siddheshmm/photoresistor-reservoir/echo_state_check.png

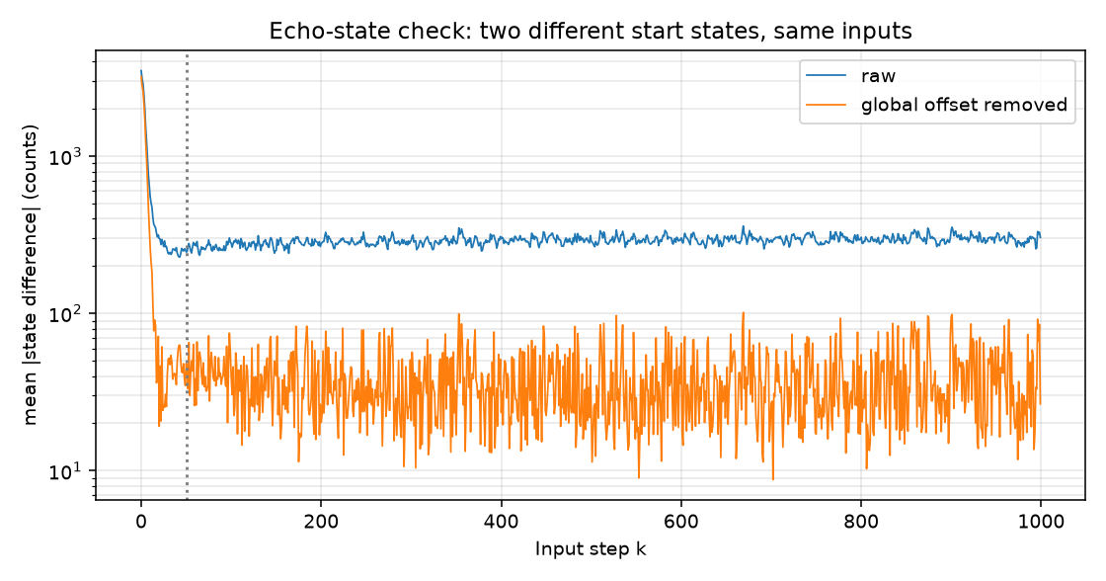
echo_state_check.png
