siddheshmm/photoresistor-reservoir/outputs/phase0/A_dark_noise_floor.png

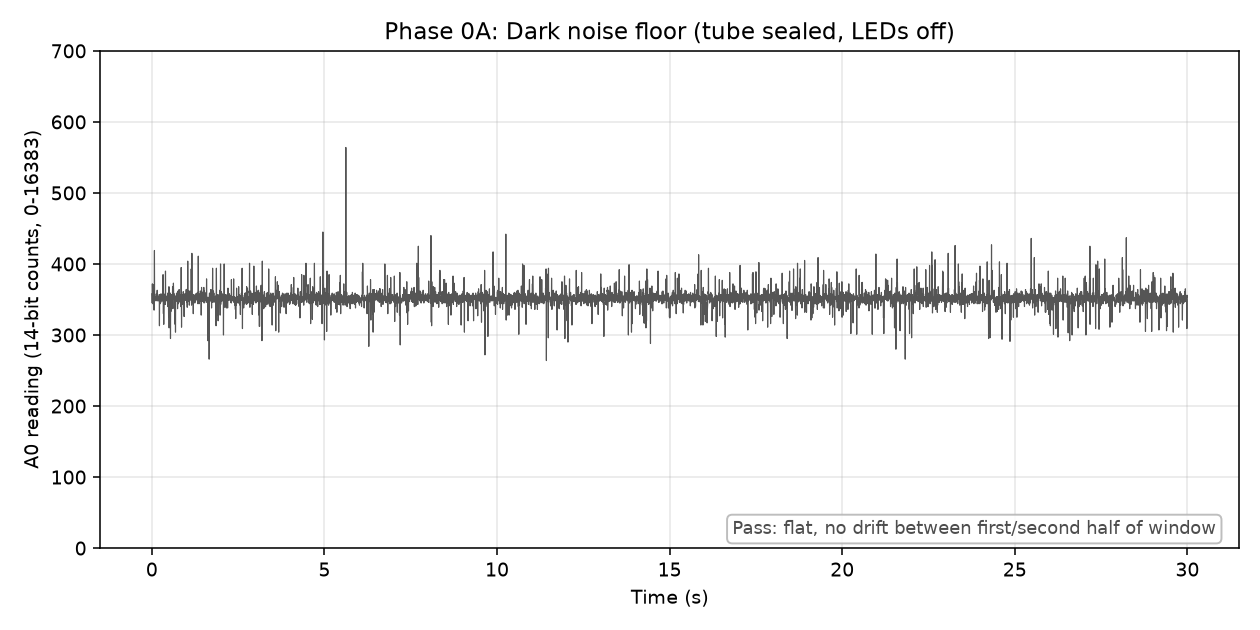
outputs/phase0/A_dark_noise_floor.png
