siddheshmm/photoresistor-reservoir/outputs/phase0/B_ambient_light_leakage.png

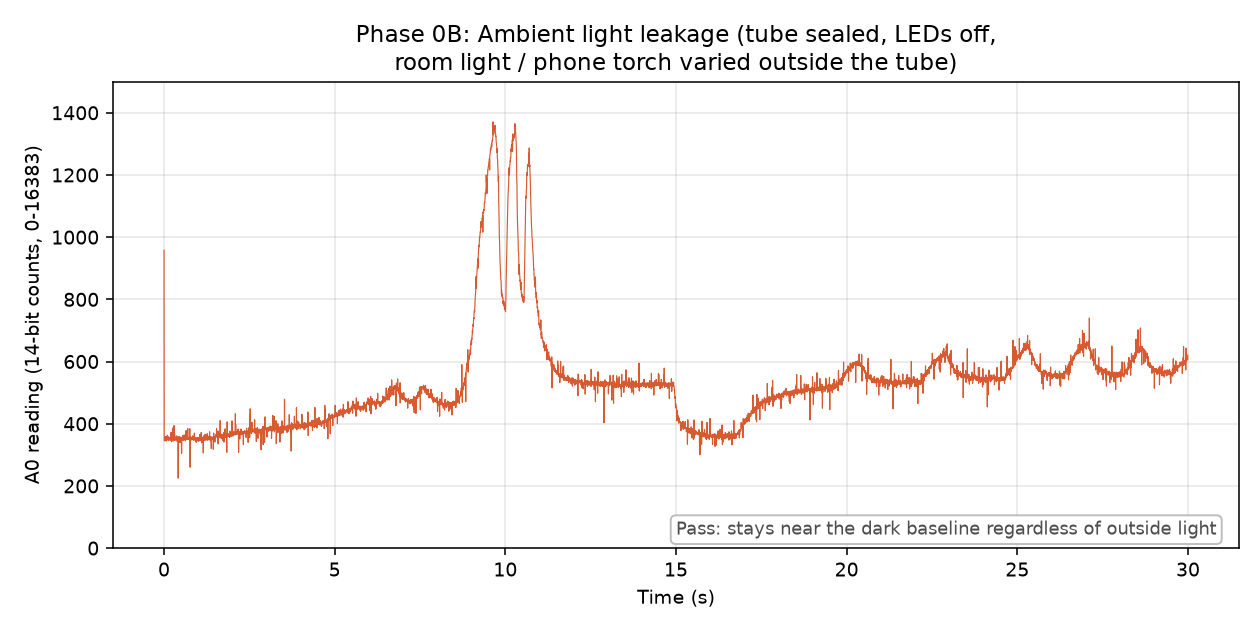
outputs/phase0/B_ambient_light_leakage.png
