siddheshmm/photoresistor-reservoir/outputs/phase0/C1_short_to_GND.png

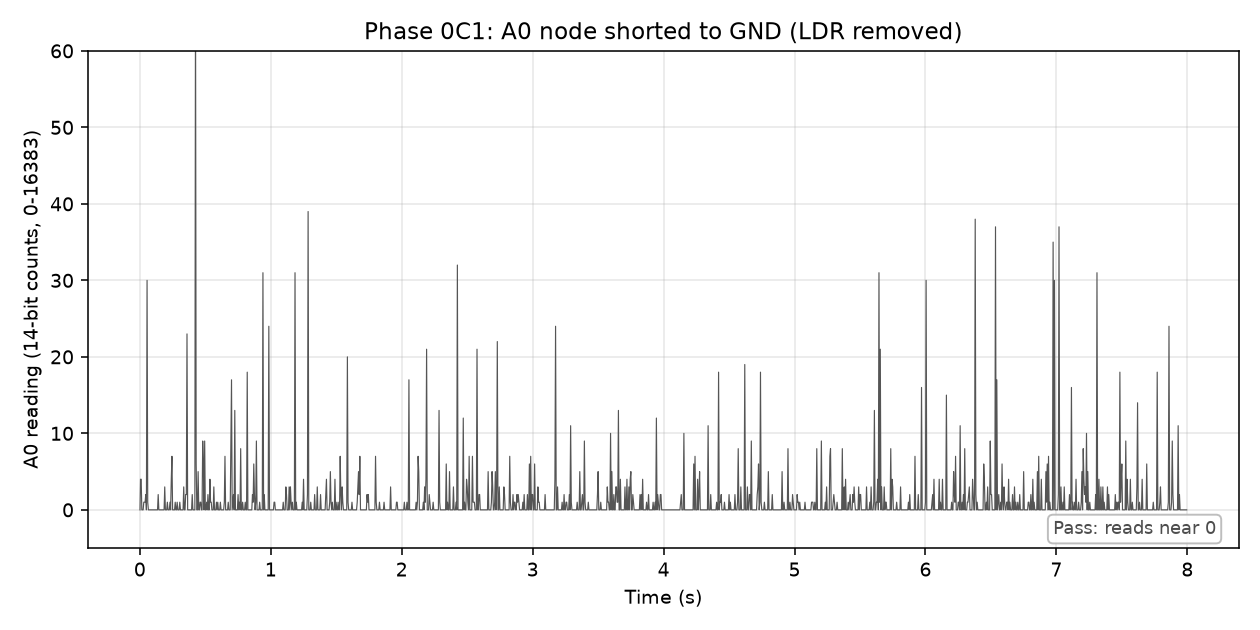
outputs/phase0/C1_short_to_GND.png
