siddheshmm/photoresistor-reservoir/outputs/phase0/C2_short_to_5V.png

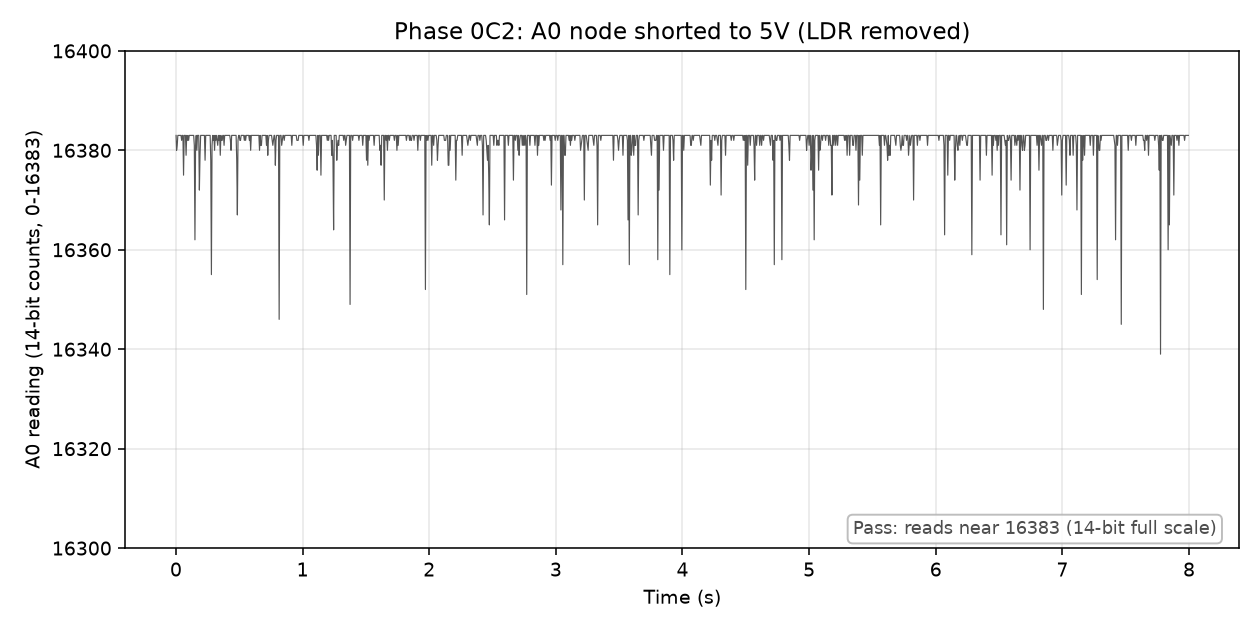
outputs/phase0/C2_short_to_5V.png
