siddheshmm/photoresistor-reservoir/outputs/phase0/phase0_overview_all_stages.png

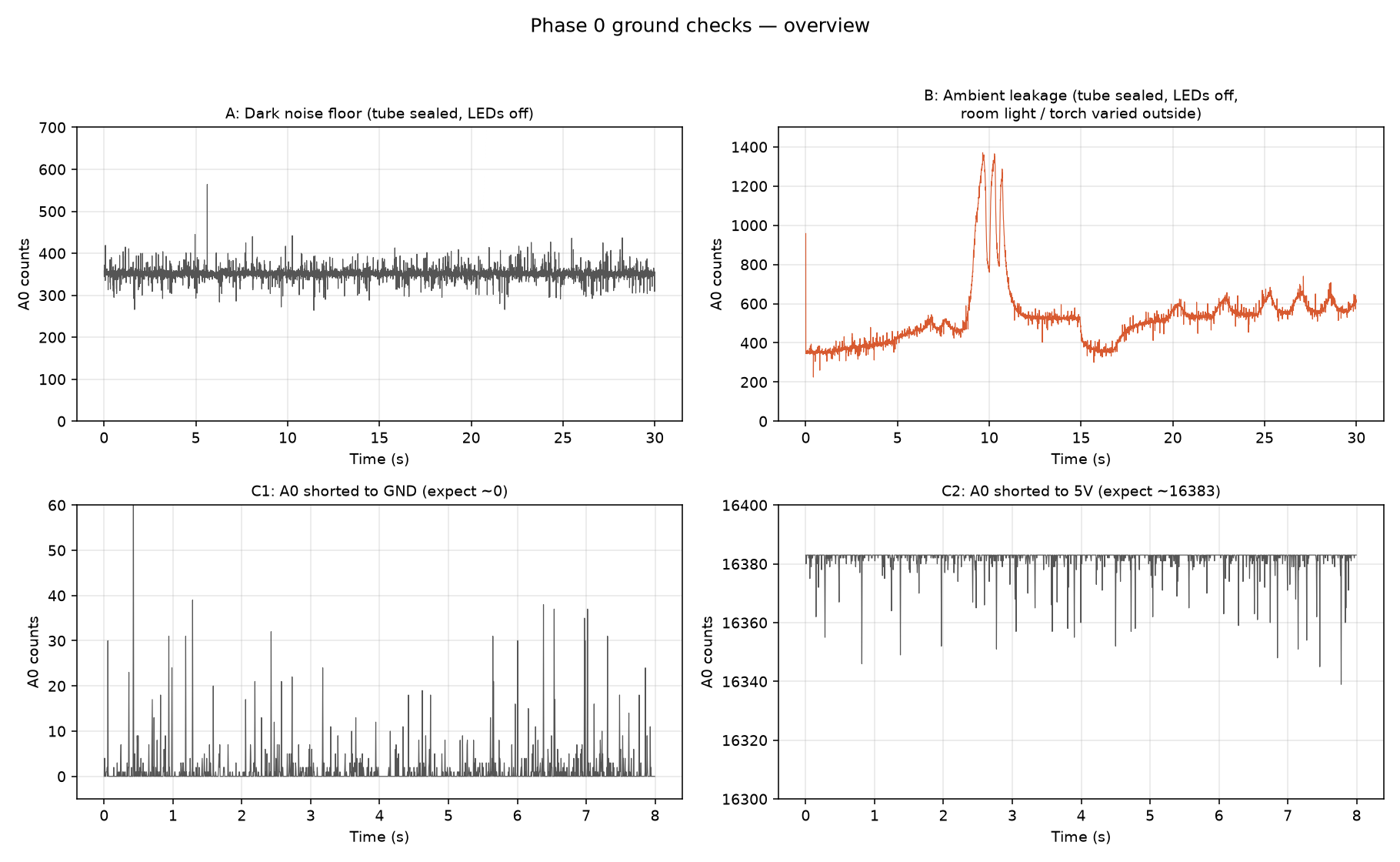
outputs/phase0/phase0_overview_all_stages.png
