siddheshmm/photoresistor-reservoir/outputs/phase1/onoff_cycles_overlaid.png

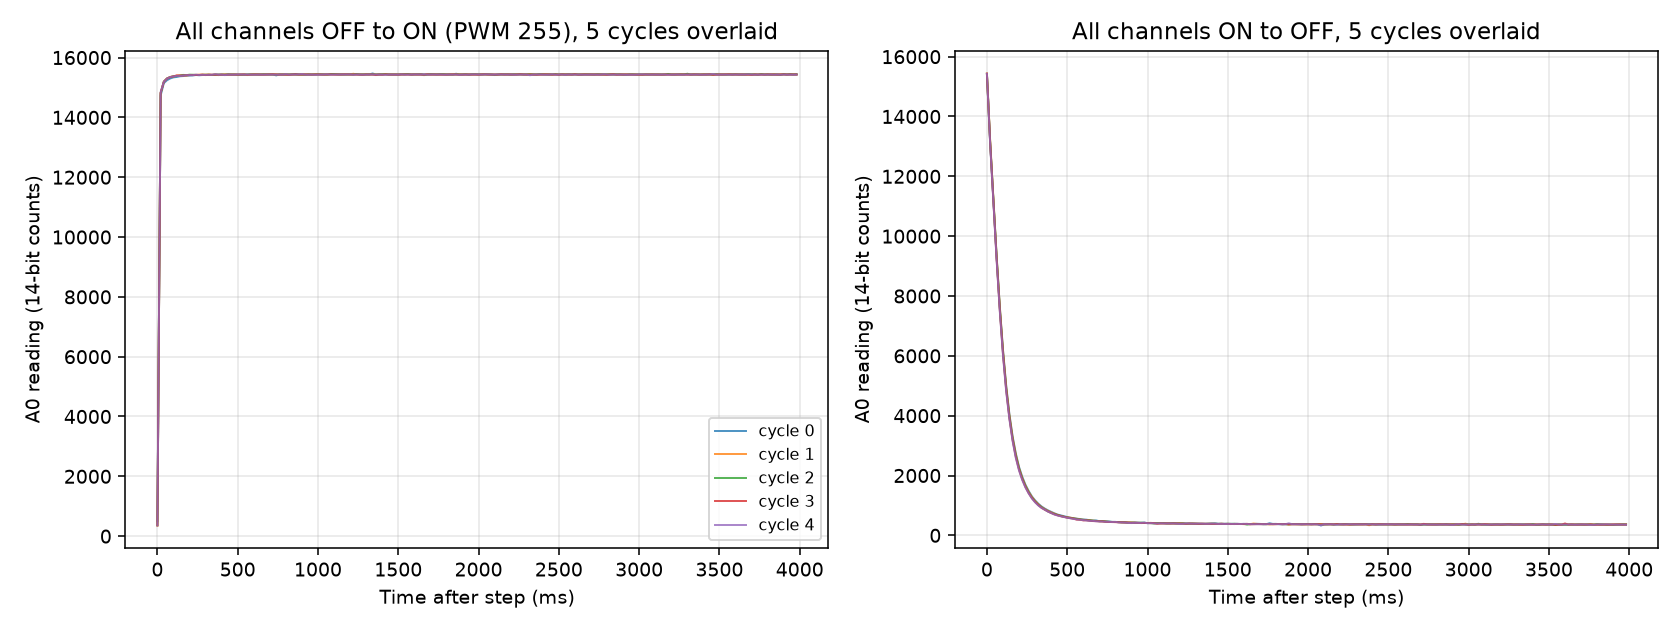
outputs/phase1/onoff_cycles_overlaid.png
