siddheshmm/photoresistor-reservoir/outputs/phase1/onoff_rise_fall_zoom.png

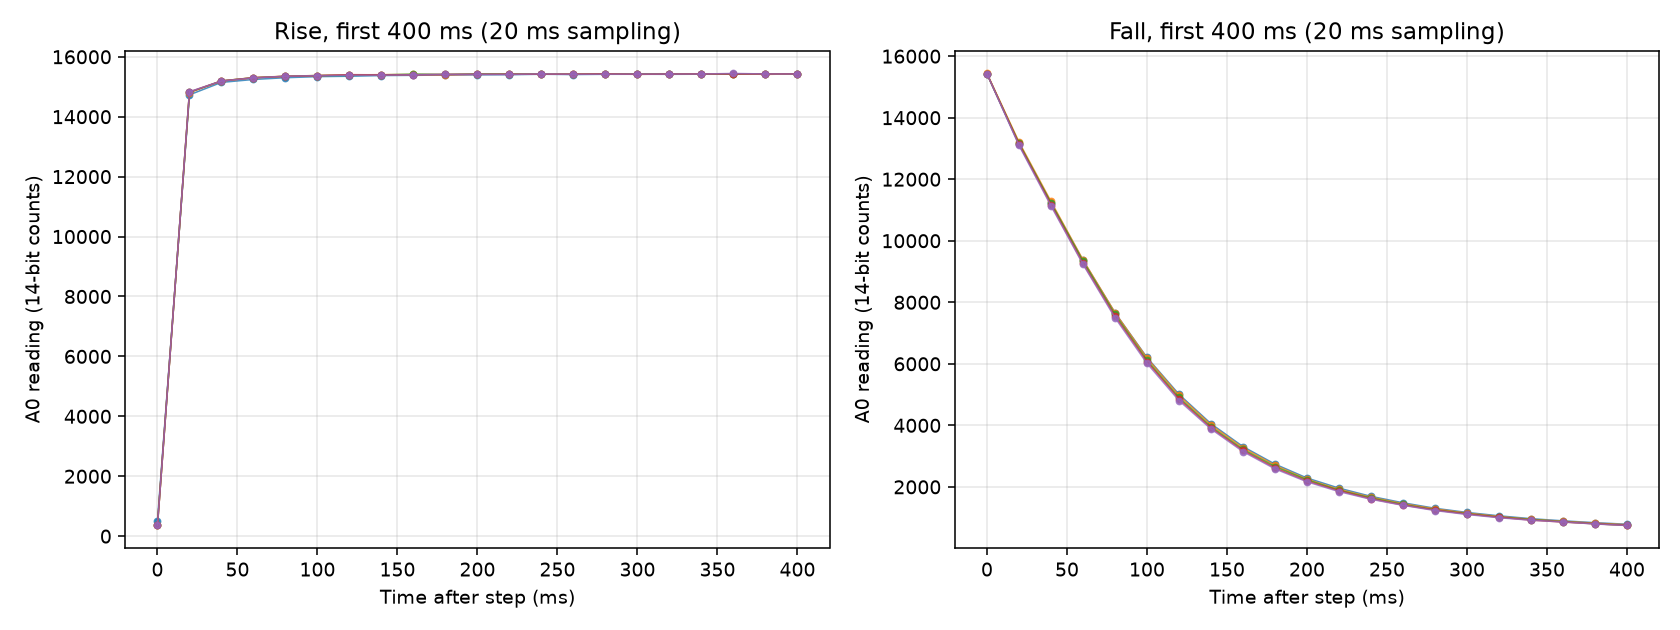
outputs/phase1/onoff_rise_fall_zoom.png
