siddheshmm/photoresistor-reservoir/outputs/phase1/sweep_plateau_vs_pwm_and_compression.png

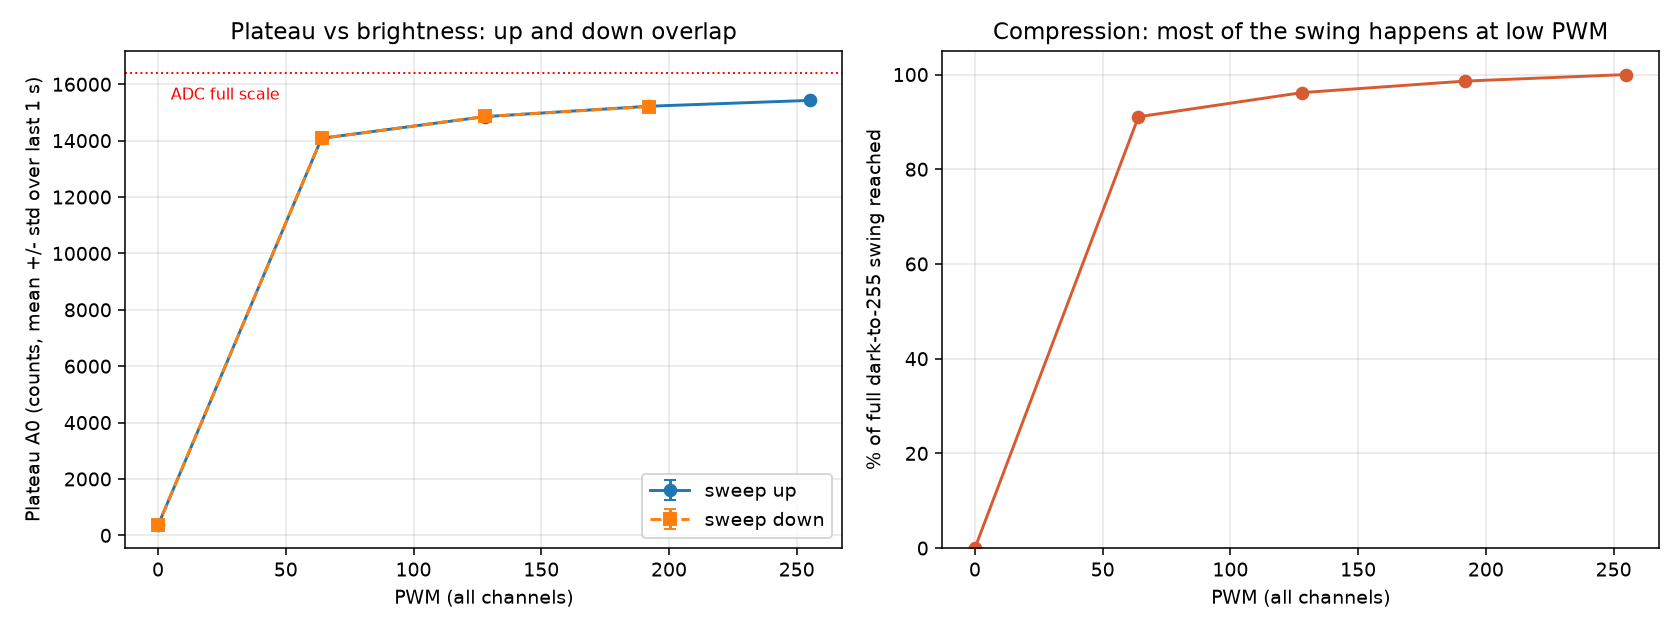
outputs/phase1/sweep_plateau_vs_pwm_and_compression.png
