siddheshmm/photoresistor-reservoir/outputs/phase1/sweep_timeseries.png

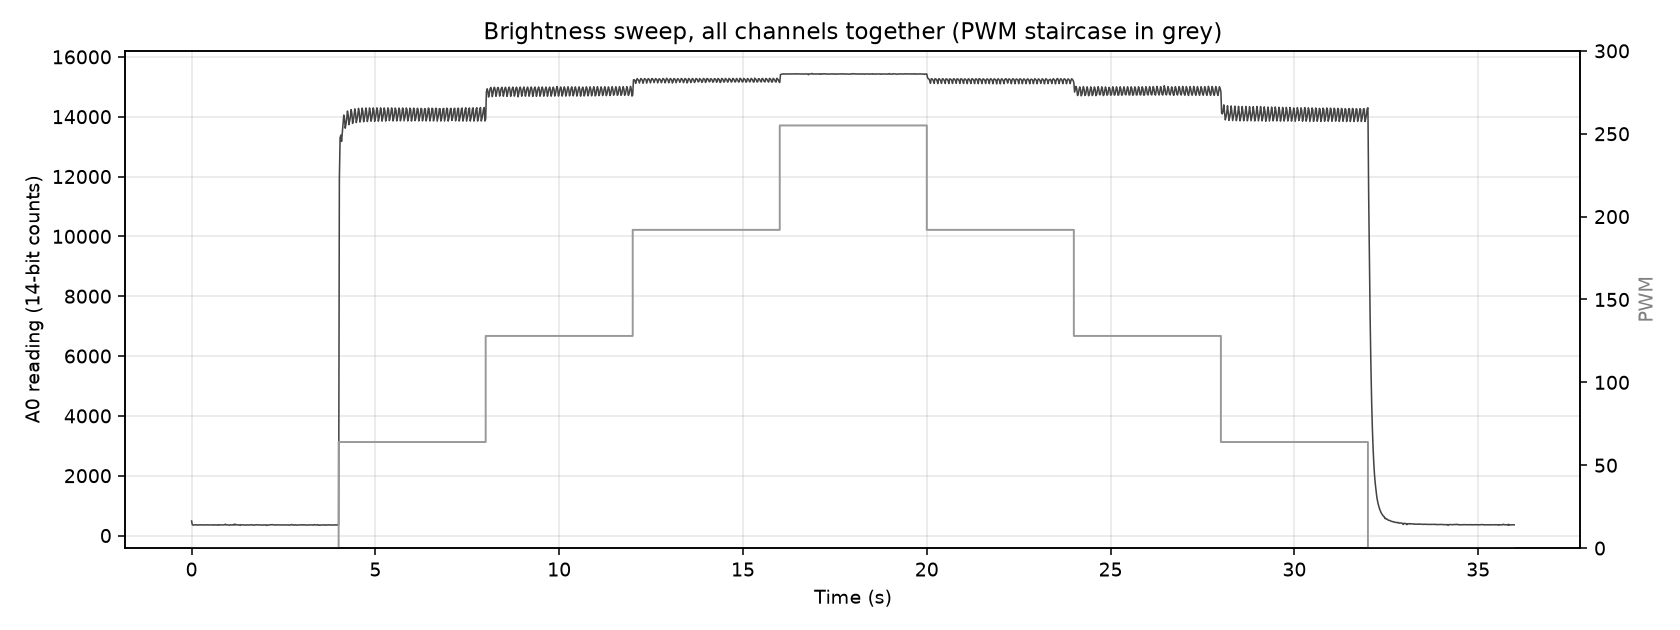
outputs/phase1/sweep_timeseries.png
