siddheshmm/photoresistor-reservoir/outputs/phase3/sweep/sweep_channel_efficiency.png

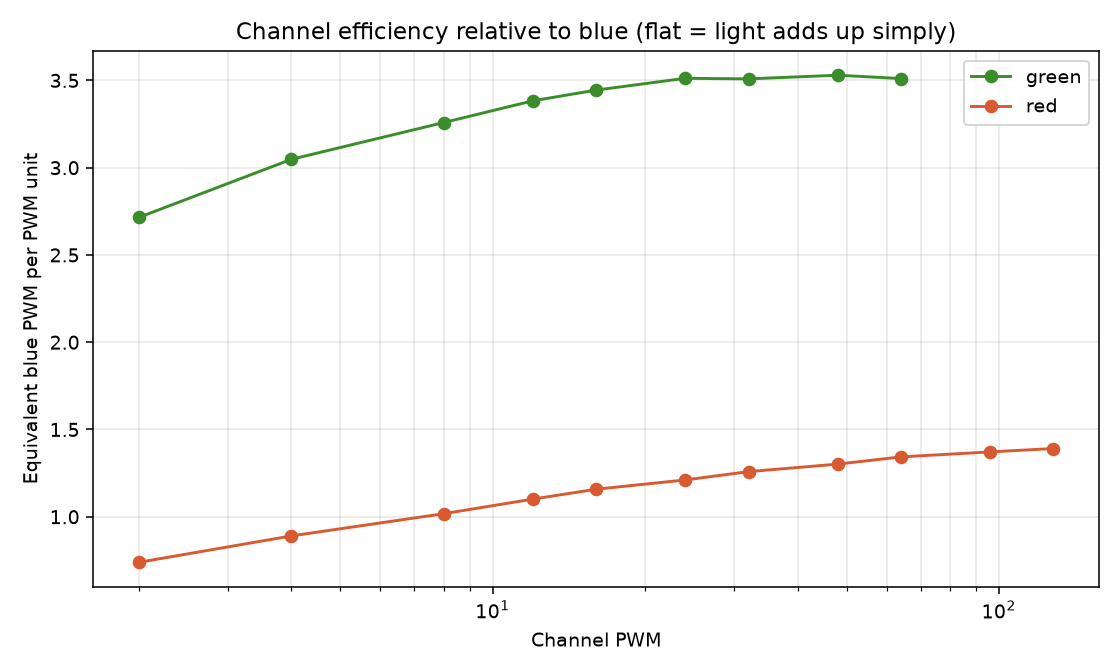
outputs/phase3/sweep/sweep_channel_efficiency.png
