siddheshmm/photoresistor-reservoir/outputs/phase3/sweep/sweep_plateau_and_sensitivity.png

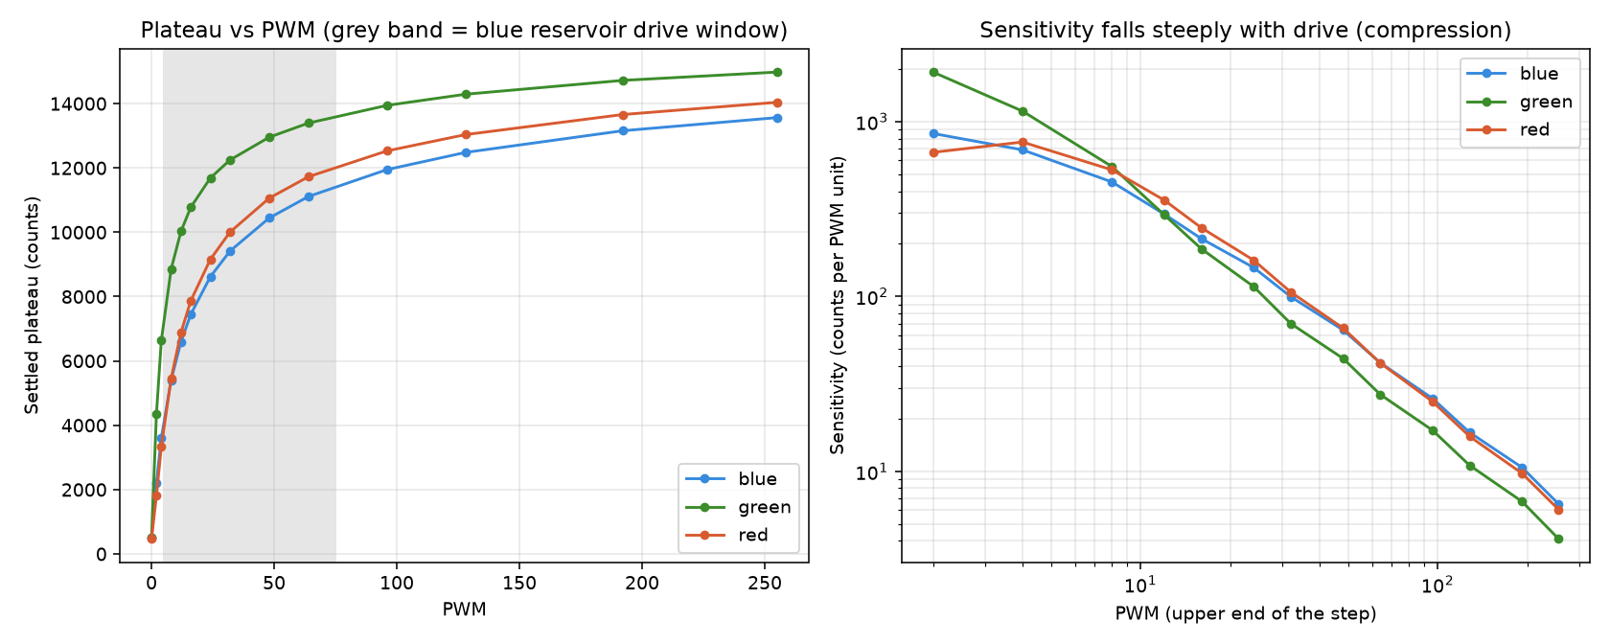
outputs/phase3/sweep/sweep_plateau_and_sensitivity.png
