siddheshmm/photoresistor-reservoir/outputs/phase3/sweep/sweep_red_feedback_model.png

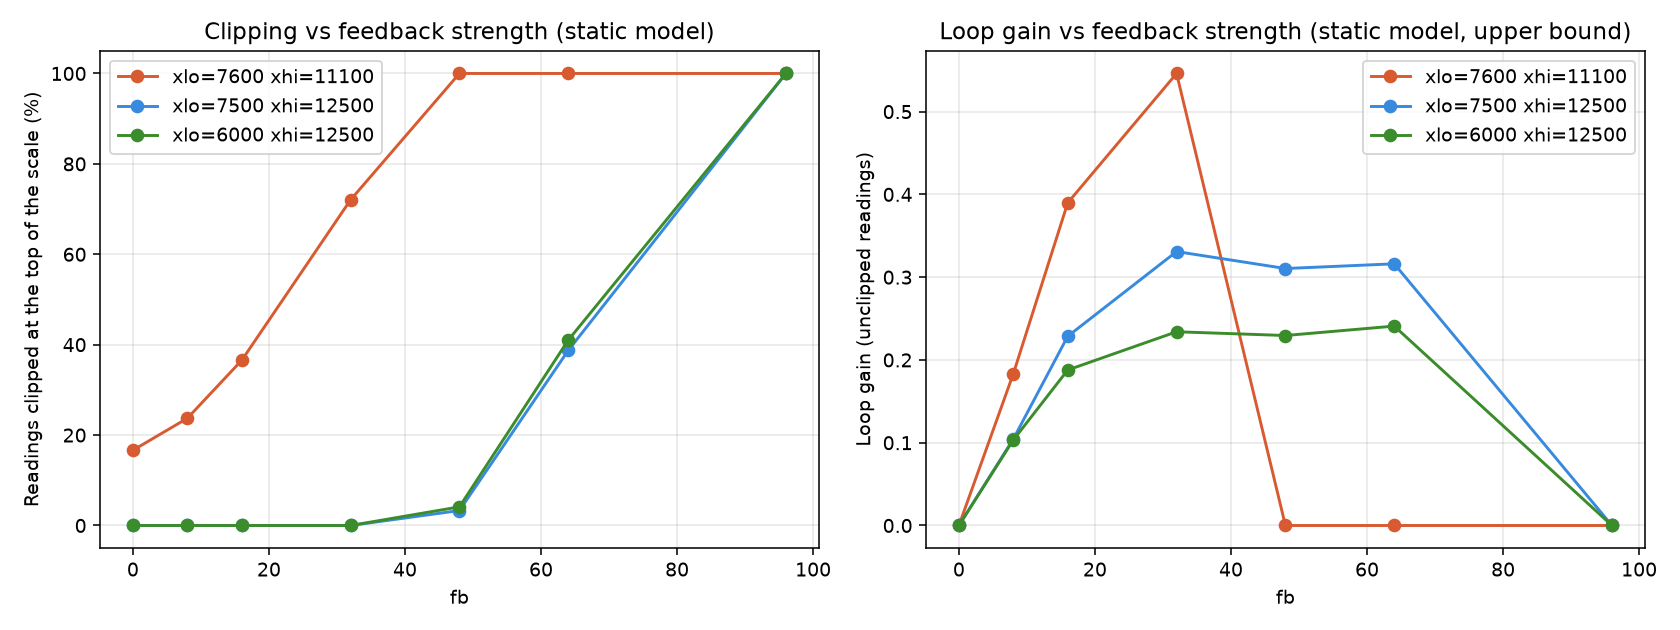
outputs/phase3/sweep/sweep_red_feedback_model.png
