siddheshmm/photoresistor-reservoir/outputs/phase3/sweep/sweep_rise_shapes.png

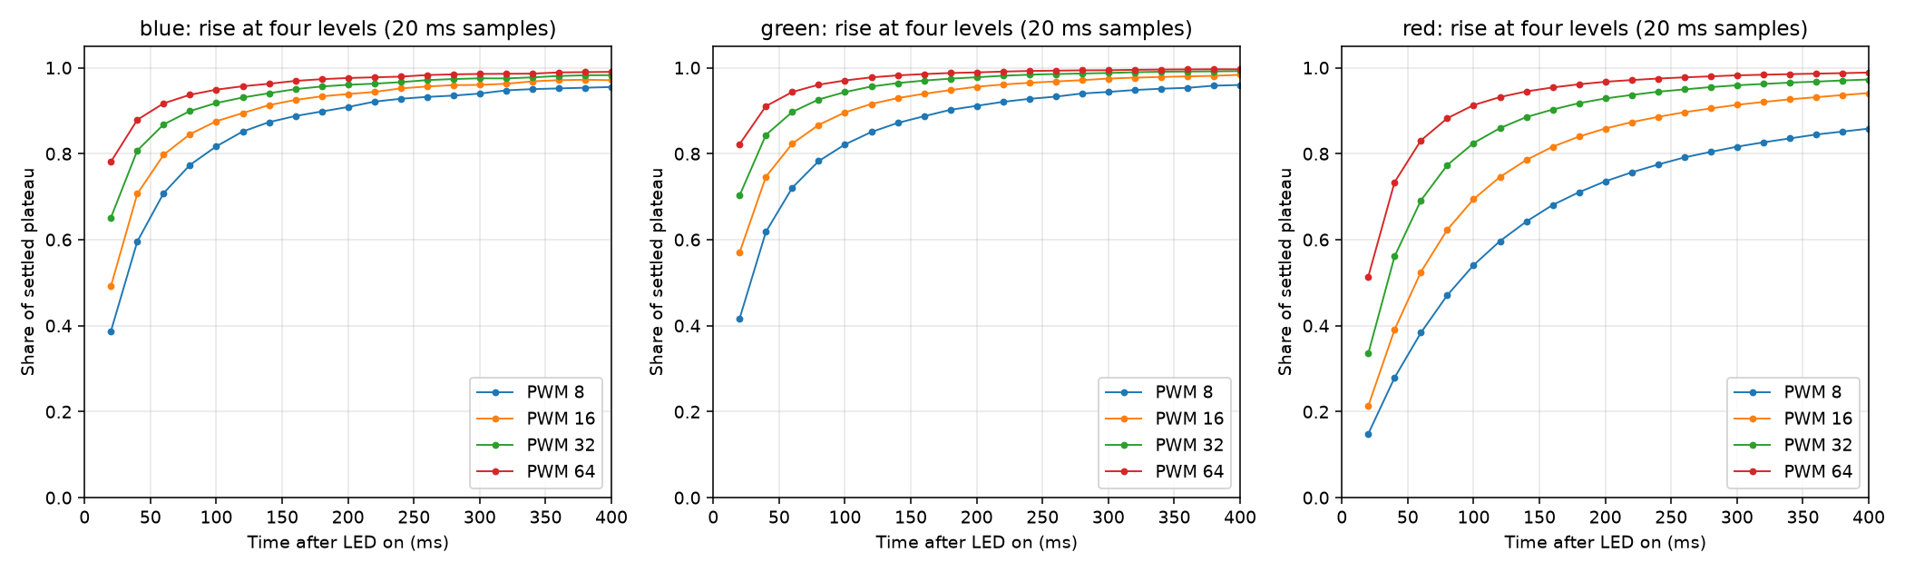
outputs/phase3/sweep/sweep_rise_shapes.png
