siddheshmm/photoresistor-reservoir/outputs/phase4/b16_fb0/input_output_map.png

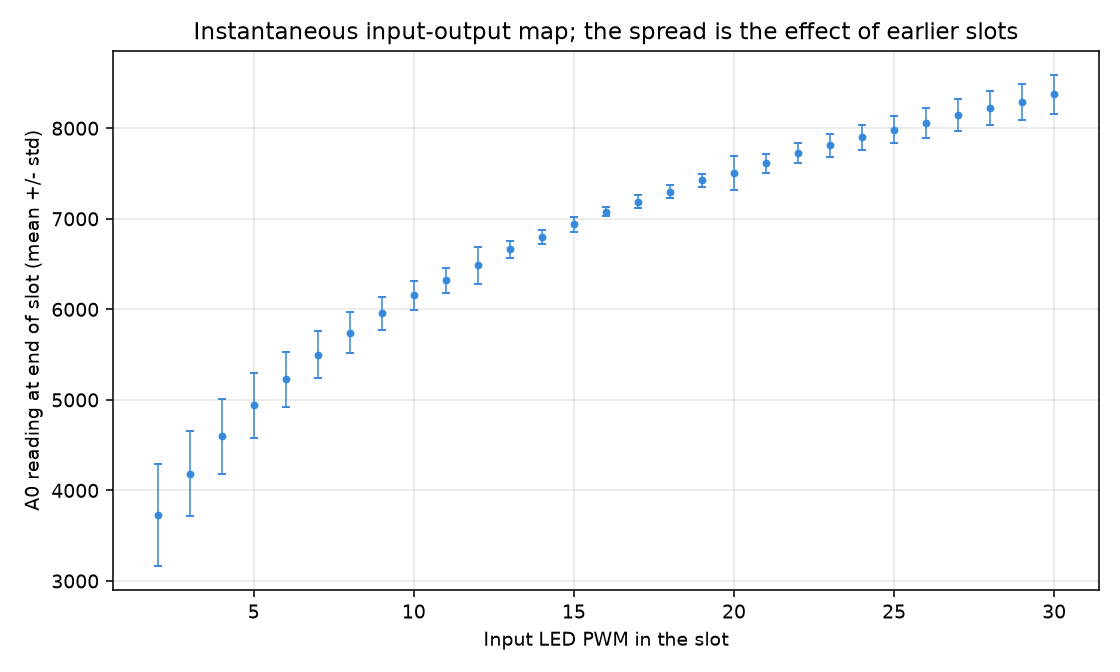
outputs/phase4/b16_fb0/input_output_map.png
