siddheshmm/photoresistor-reservoir/outputs/phase4/b16_fb0/lag_response.png

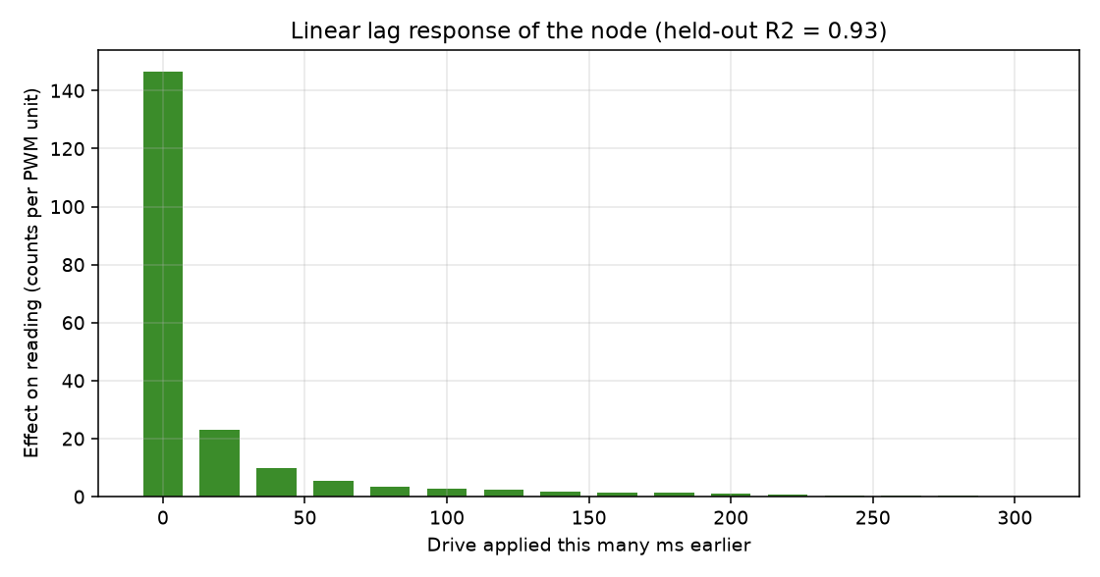
outputs/phase4/b16_fb0/lag_response.png
