siddheshmm/photoresistor-reservoir/outputs/phase4/b16_fb0/memory_capacity.png

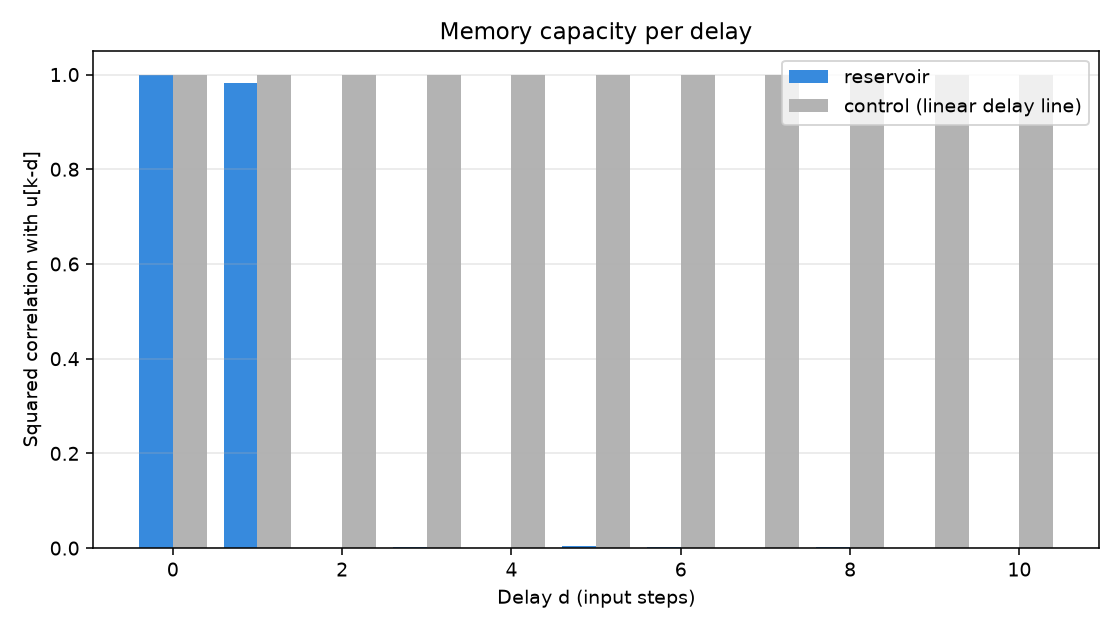
outputs/phase4/b16_fb0/memory_capacity.png
