siddheshmm/photoresistor-reservoir/outputs/phase4/b16_fb0/narma_prediction_example.png

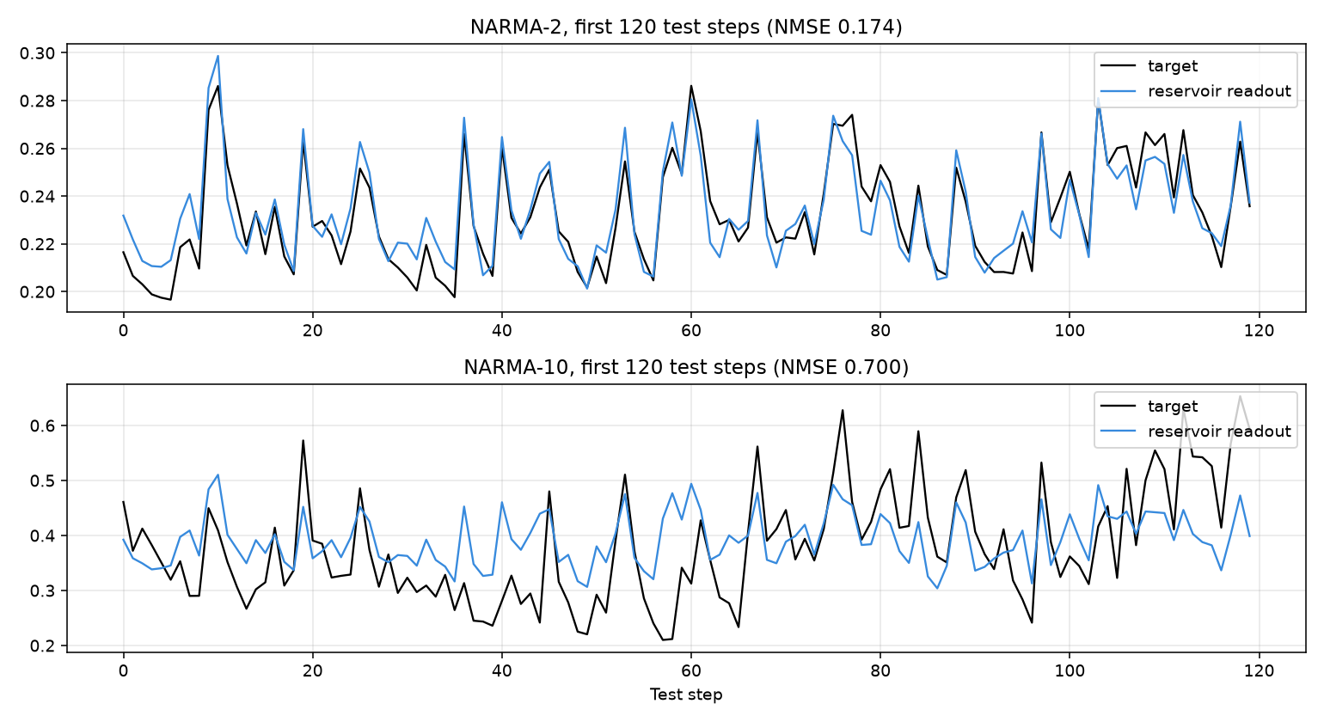
outputs/phase4/b16_fb0/narma_prediction_example.png
