siddheshmm/photoresistor-reservoir/outputs/phase4/b16_fb0/state_distribution_and_nodes.png

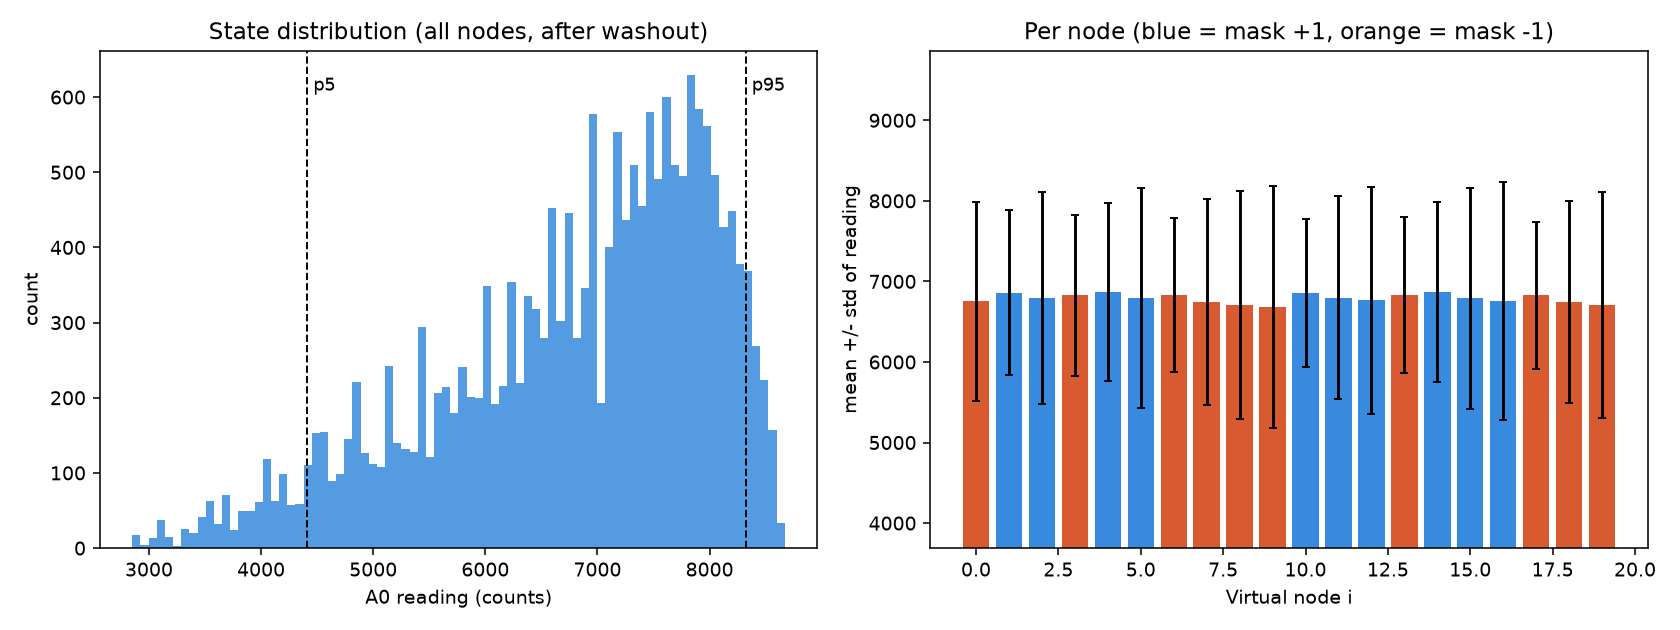
outputs/phase4/b16_fb0/state_distribution_and_nodes.png
