siddheshmm/photoresistor-reservoir/outputs/phase4/b16_fb0/state_traces_example.png

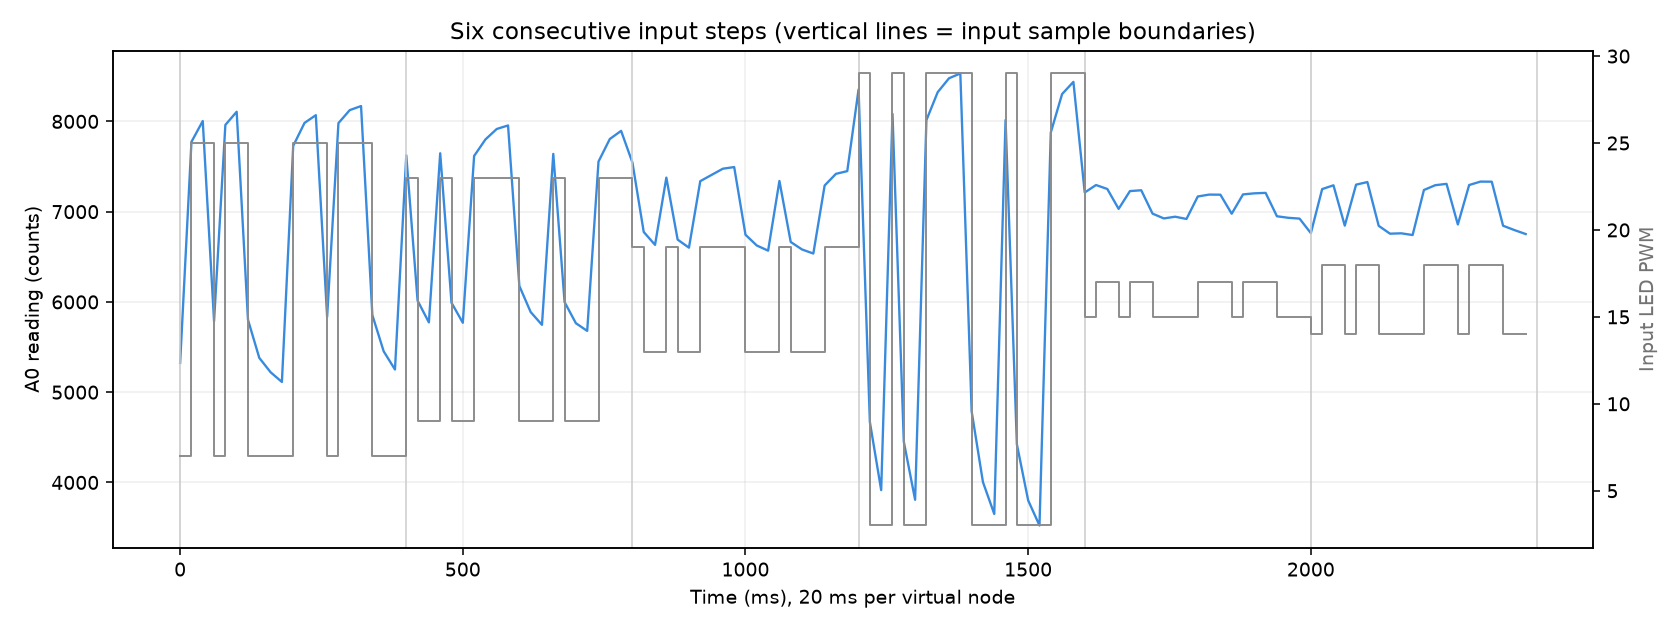
outputs/phase4/b16_fb0/state_traces_example.png
