siddheshmm/photoresistor-reservoir/outputs/phase4/b16_fb0/tasks_vs_control.png

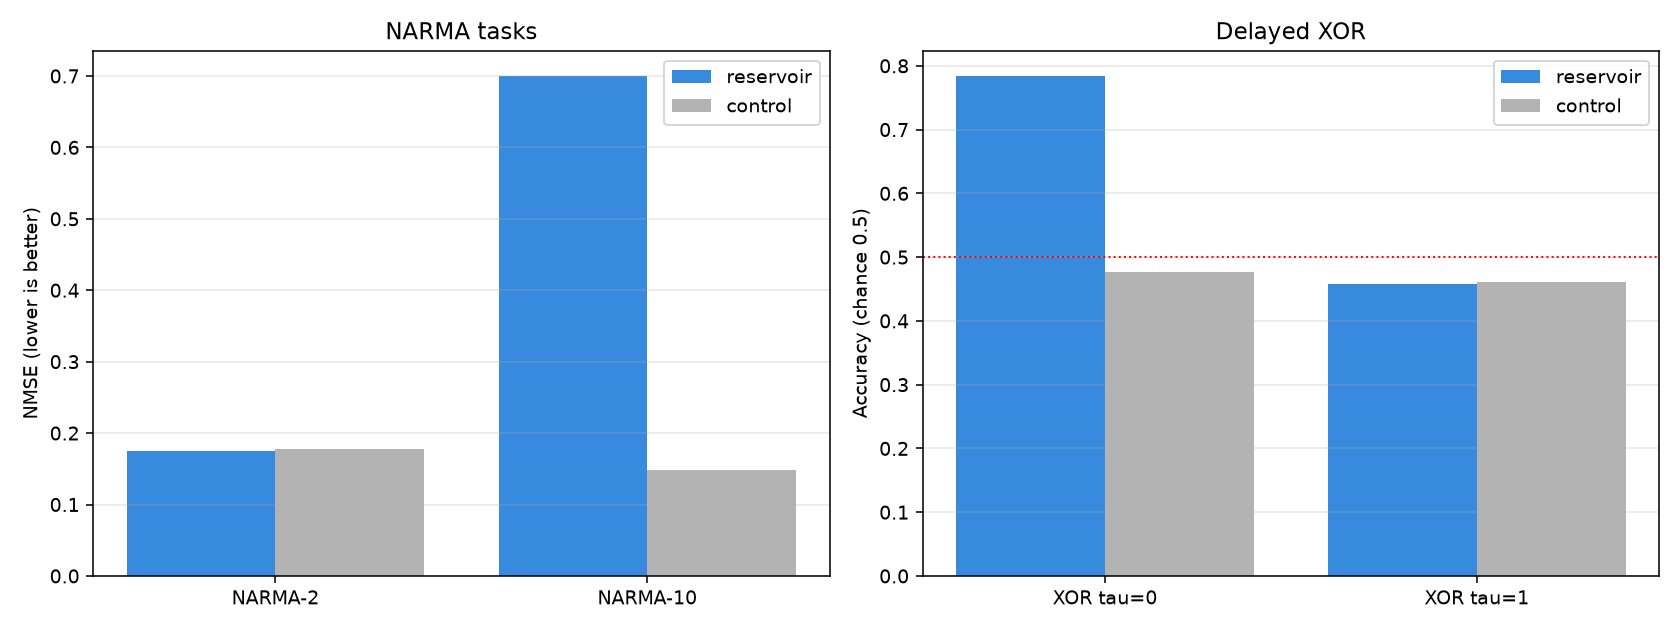
outputs/phase4/b16_fb0/tasks_vs_control.png
