siddheshmm/photoresistor-reservoir/outputs/phase4/b16_fb32/memory_capacity.png

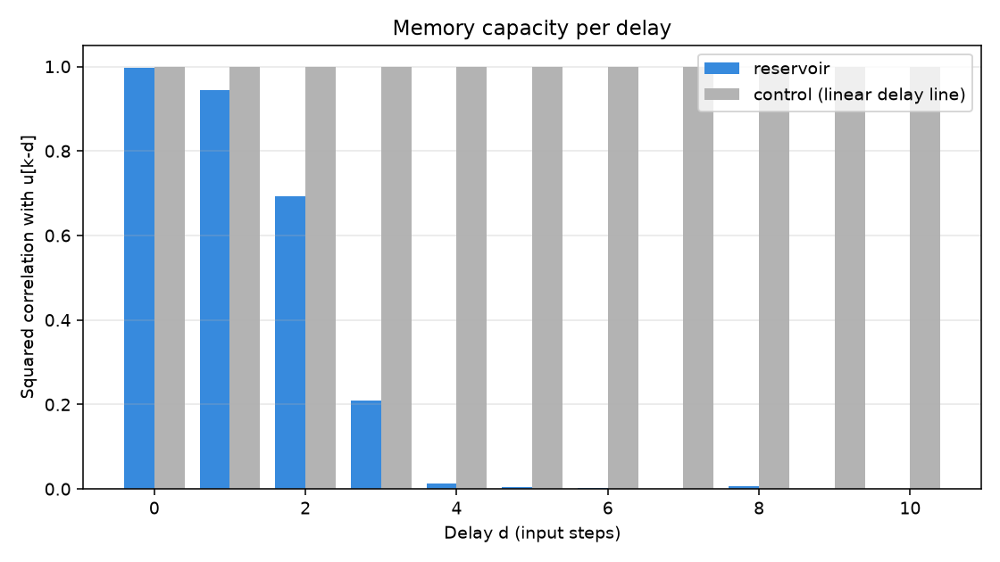
outputs/phase4/b16_fb32/memory_capacity.png
