siddheshmm/photoresistor-reservoir/outputs/phase4/b16f32_runs/narma_prediction_example.png

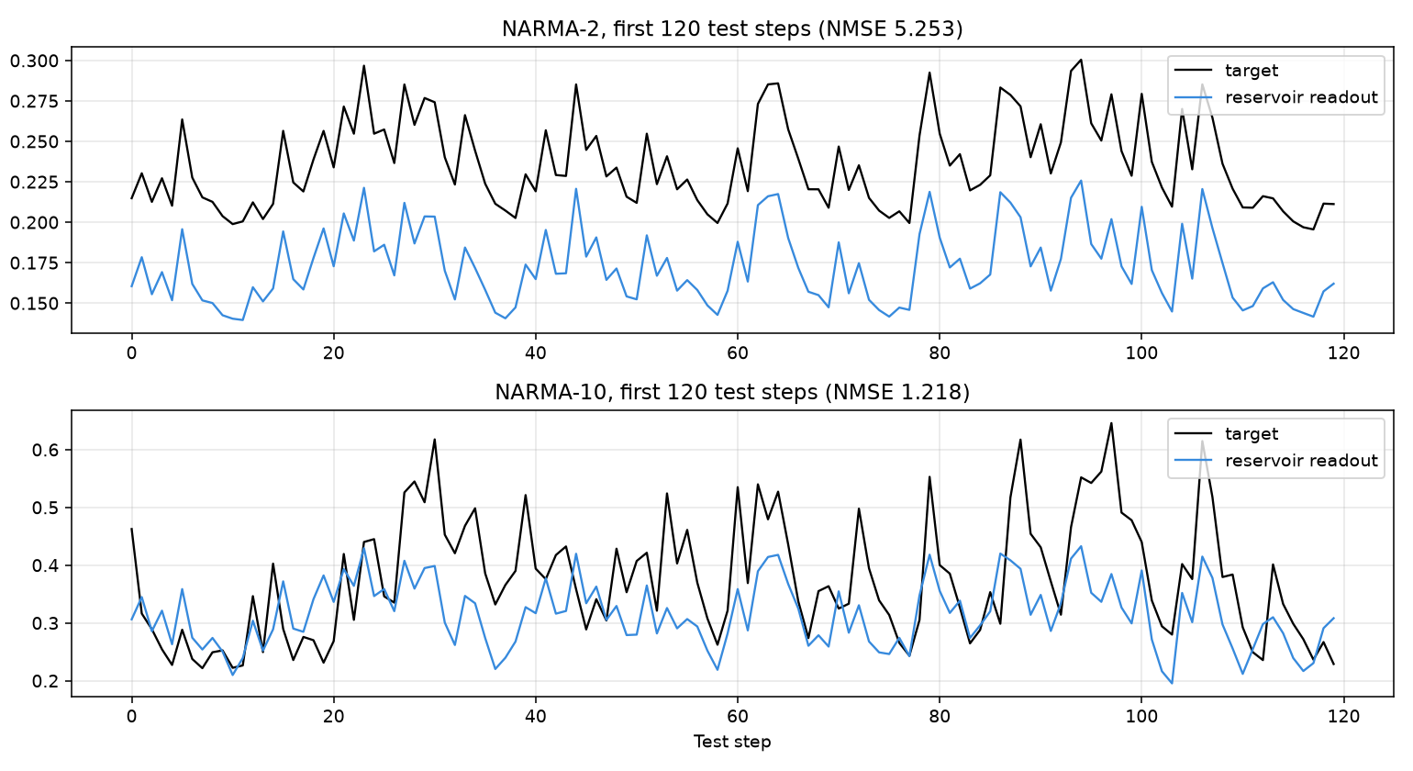
outputs/phase4/b16f32_runs/narma_prediction_example.png
