siddheshmm/photoresistor-reservoir/outputs/phase4/b16f32_runs/tasks_vs_control.png

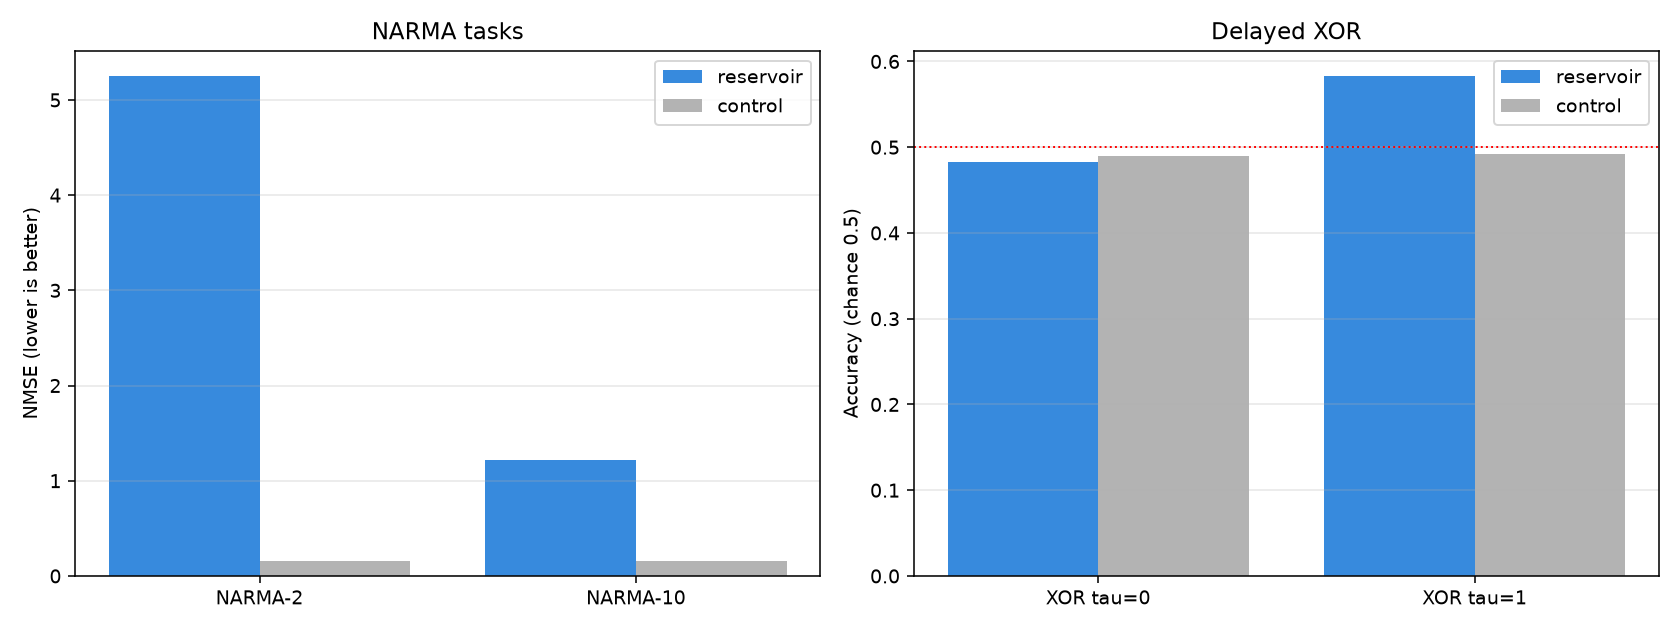
outputs/phase4/b16f32_runs/tasks_vs_control.png
