siddheshmm/photoresistor-reservoir/outputs/phase4/b16f32_runs_center/narma_prediction_example.png

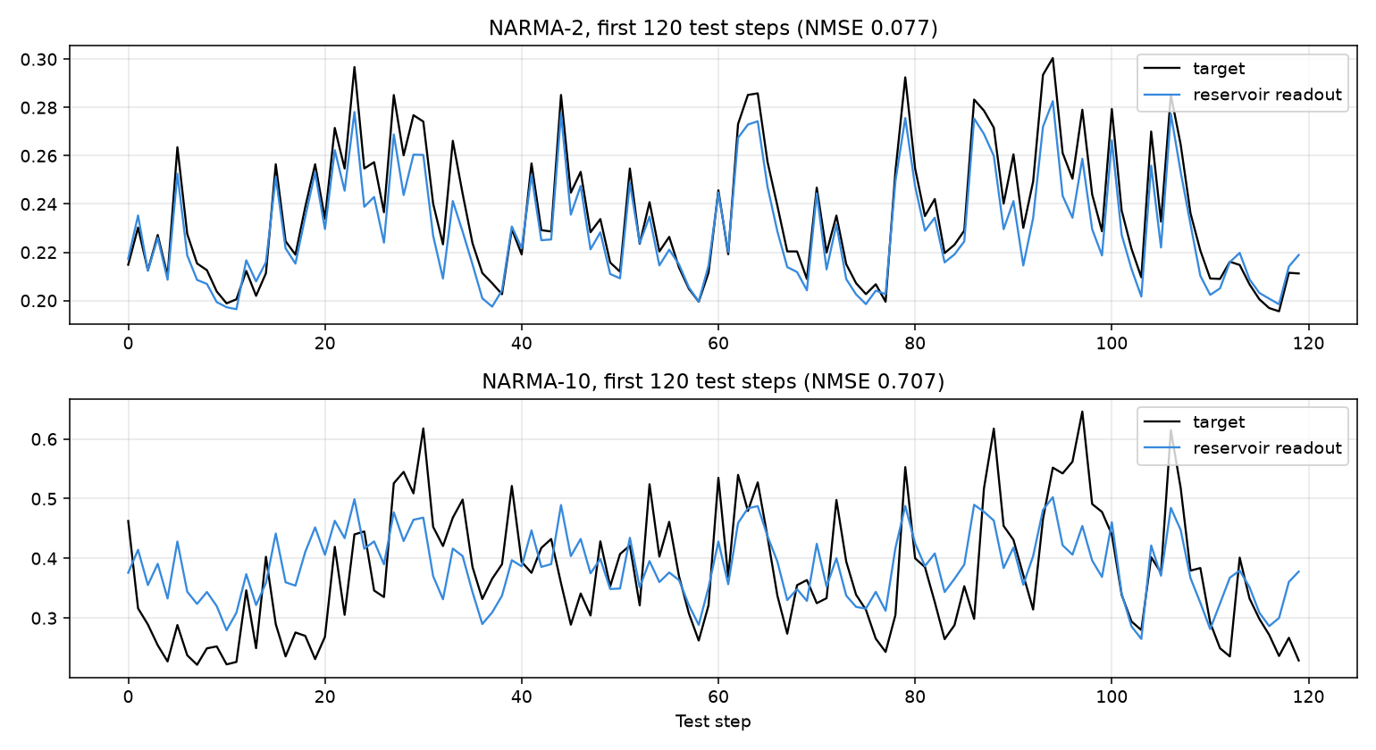
outputs/phase4/b16f32_runs_center/narma_prediction_example.png
