siddheshmm/photoresistor-reservoir/outputs/phase4/fb32/echo_state_check.png

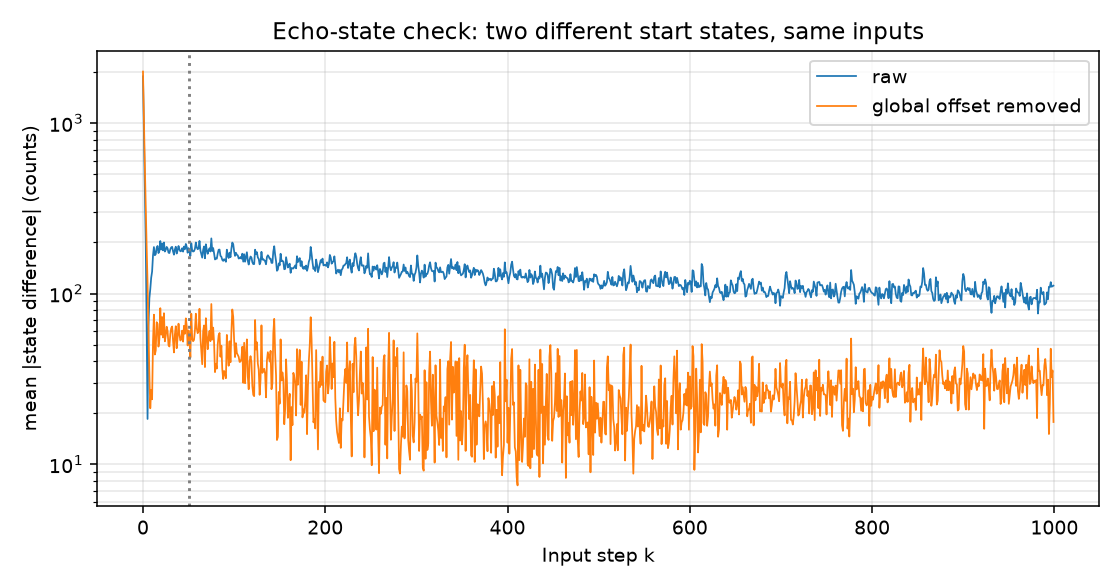
outputs/phase4/fb32/echo_state_check.png
