siddheshmm/photoresistor-reservoir/outputs/phase4/fb32/input_output_map.png

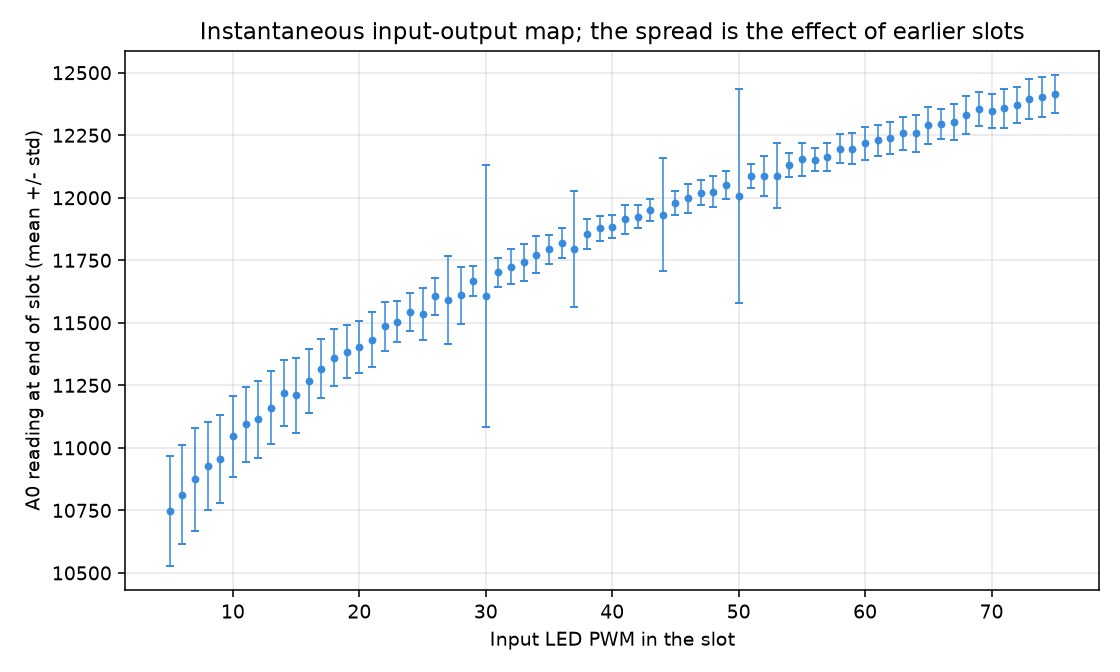
outputs/phase4/fb32/input_output_map.png
