siddheshmm/photoresistor-reservoir/outputs/phase4/fb32/state_distribution_and_nodes.png

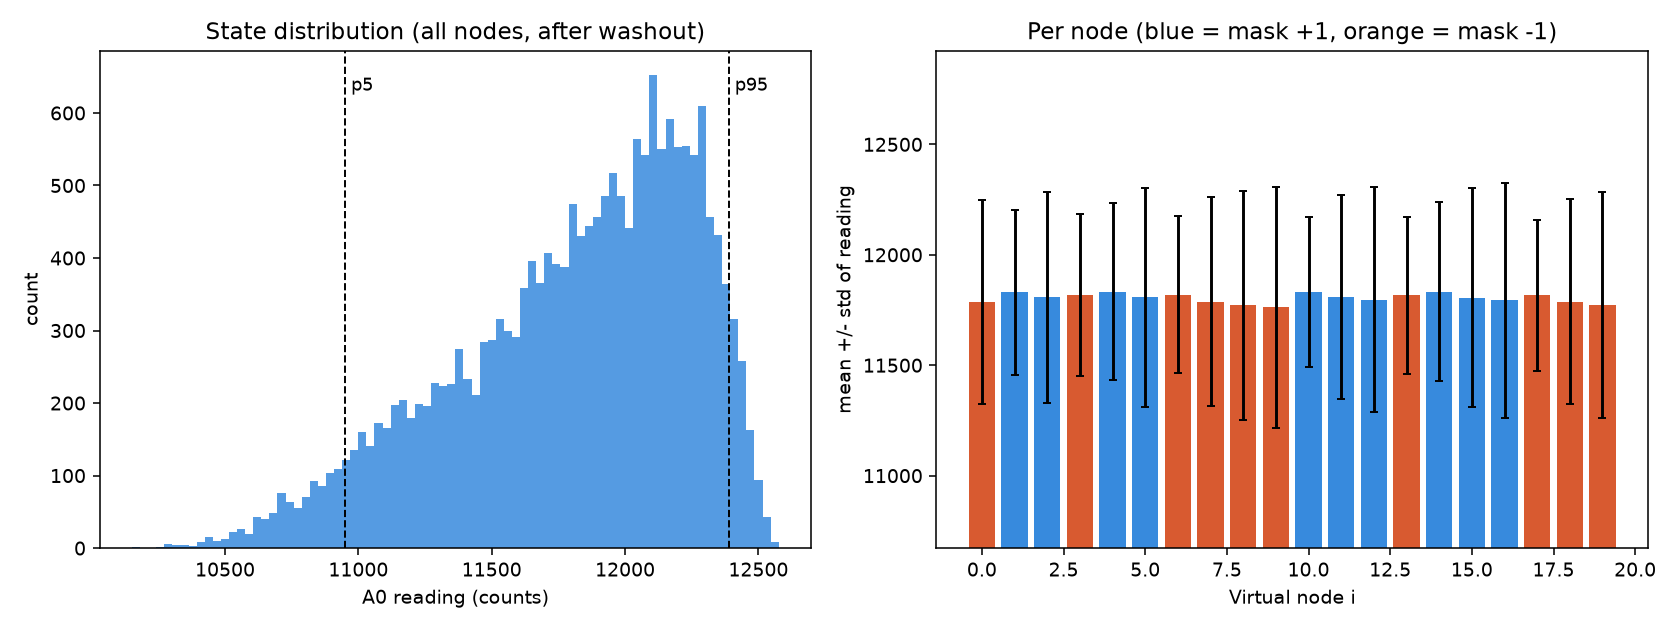
outputs/phase4/fb32/state_distribution_and_nodes.png
