siddheshmm/photoresistor-reservoir/outputs/phase4/fb32/state_traces_example.png

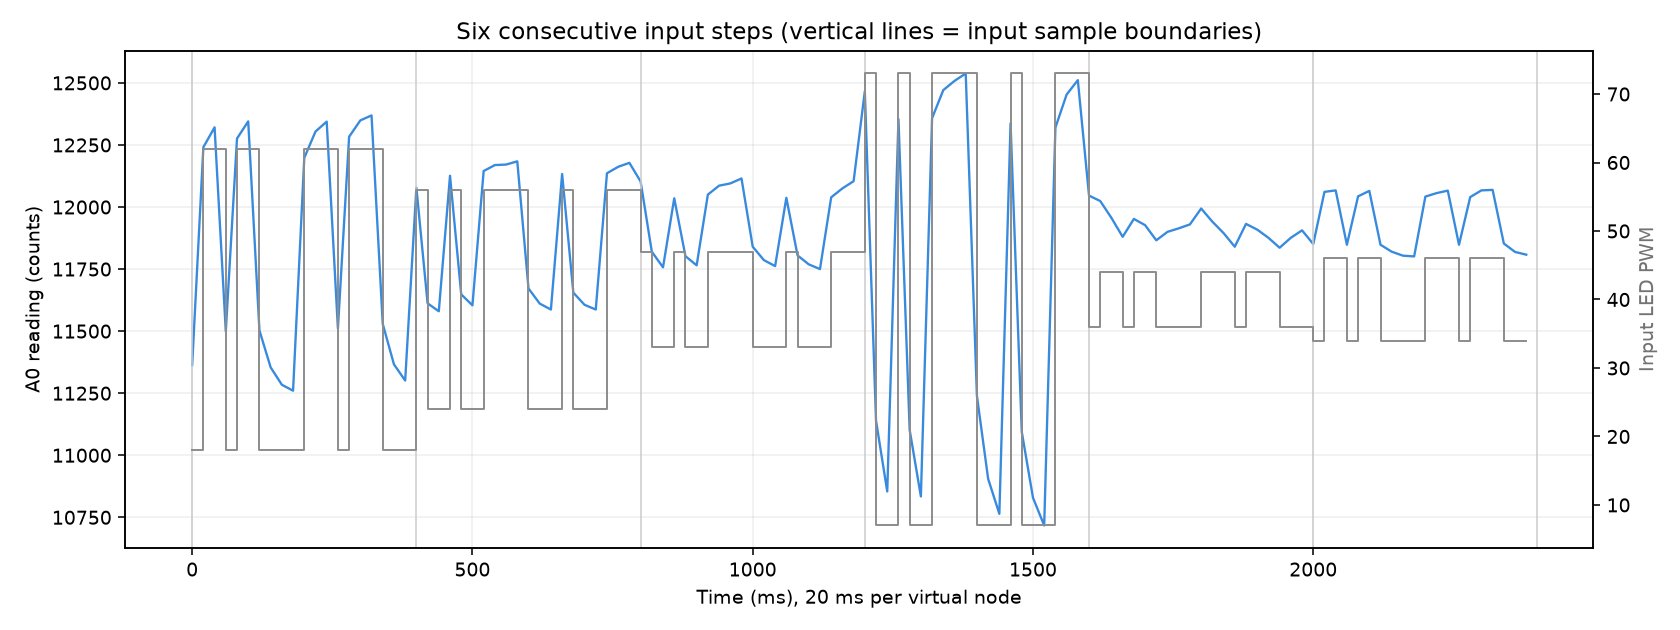
outputs/phase4/fb32/state_traces_example.png
