siddheshmm/photoresistor-reservoir/outputs/phase4/fb32/tasks_vs_control.png

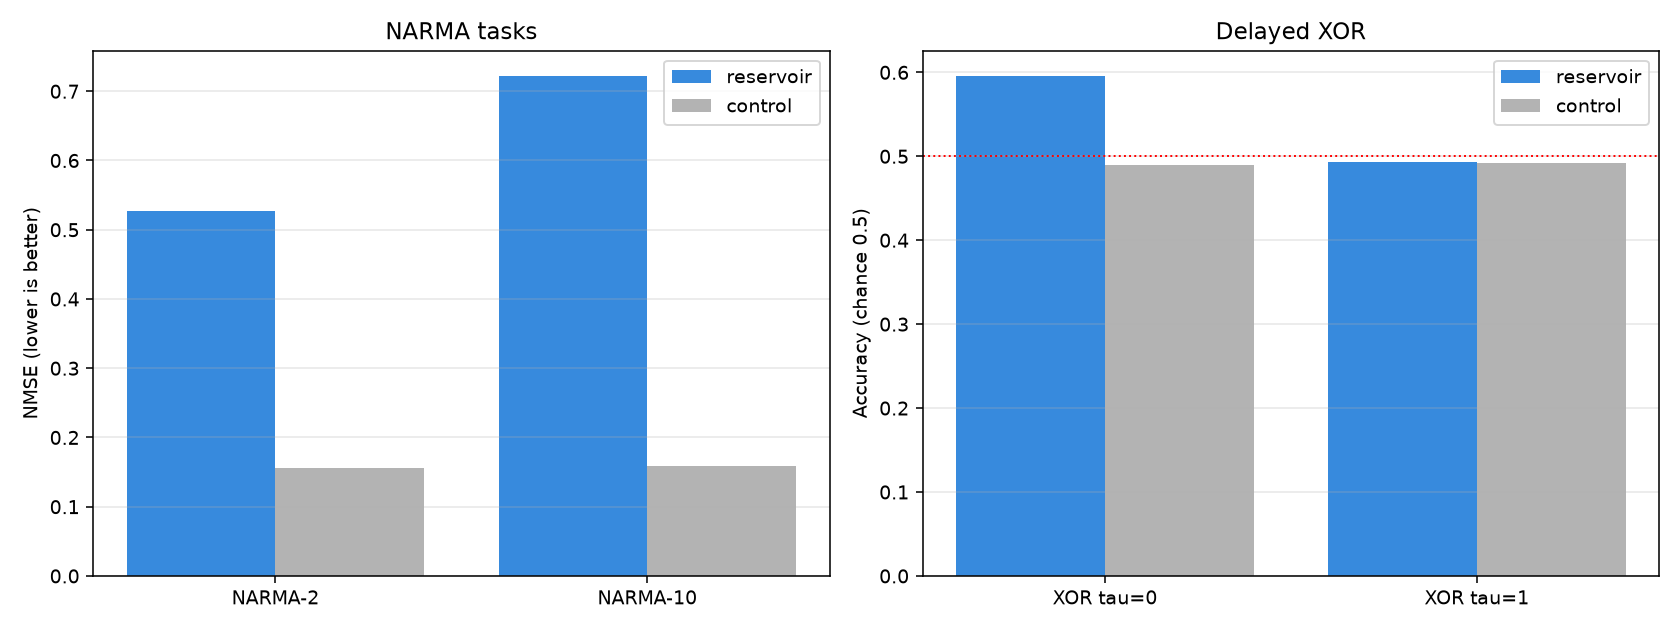
outputs/phase4/fb32/tasks_vs_control.png
