siddheshmm/photoresistor-reservoir/outputs/phase2/channel_B_repeats_and_orders.png

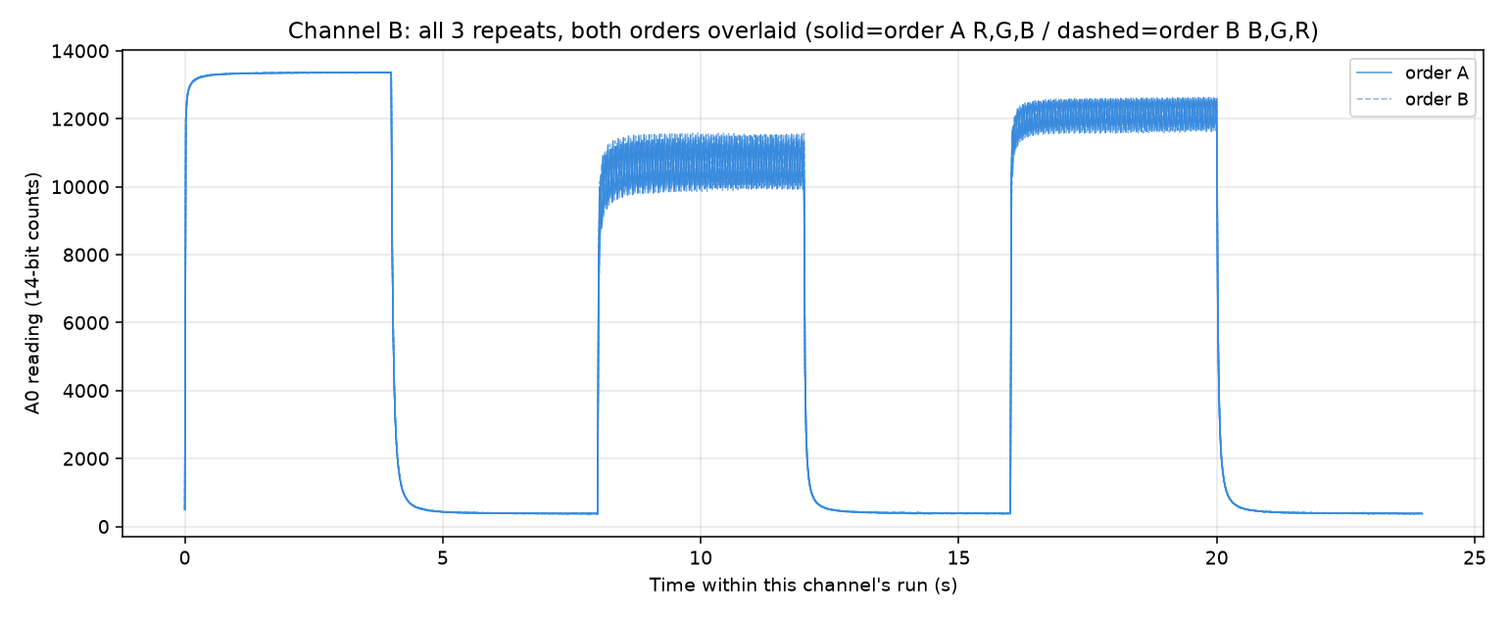
outputs/phase2/channel_B_repeats_and_orders.png
