siddheshmm/photoresistor-reservoir/outputs/phase2/plateau_summary_by_channel_order.png

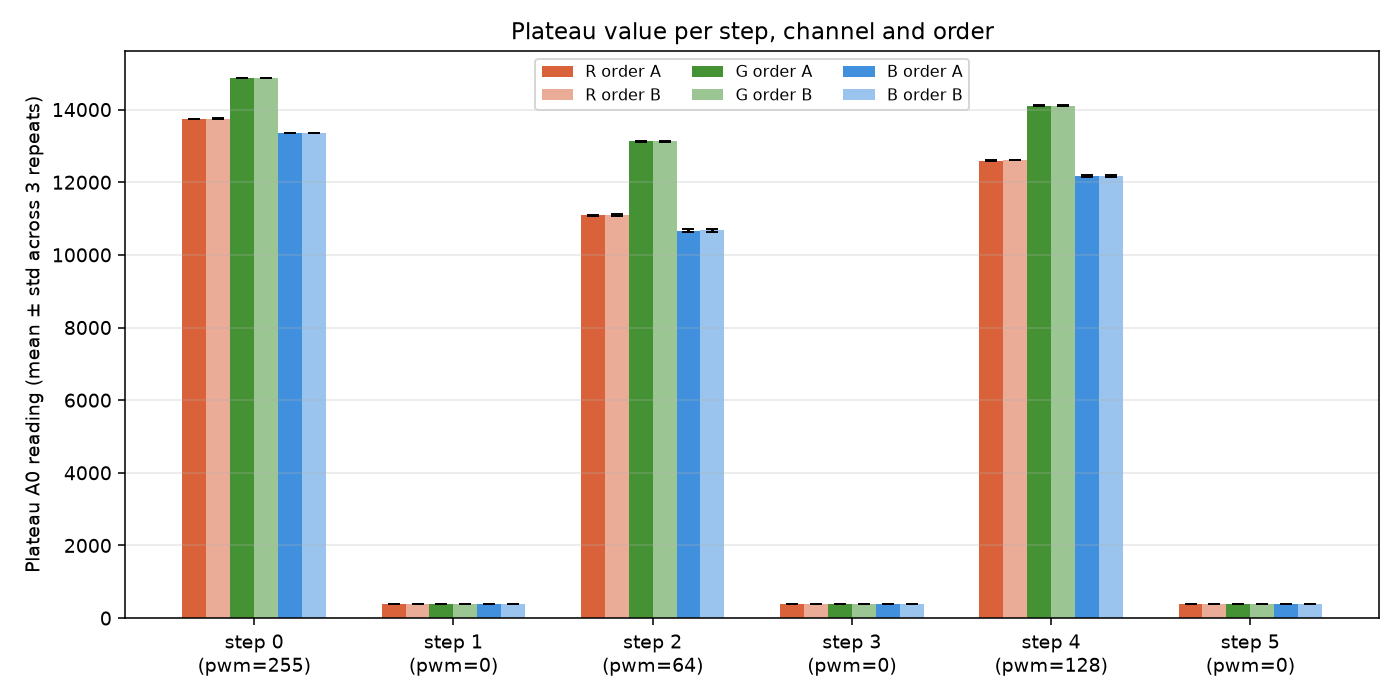
outputs/phase2/plateau_summary_by_channel_order.png
