siddheshmm/photoresistor-reservoir/(commit log)

2026-10-07 Phase 0 - testing LDR as a component
    [phase0.csv]
2026-10-07 Phase 2 - Per channel effect RGB
    [phase2.csv]
2026-10-07 [added] phase 0 arduino protocol code
2026-10-12 Phase 1 - White baseline
    [phase1.csv]
2026-10-15 Phase 3 - No feedback reservoir
    [blue_s1_bright.csv, blue_s1_dark.csv, blue_s1_dark_rep.csv, blue_s2_dark.csv, green_s1_dark.csv, green_s2_dark.csv, sweep_blue.csv, sweep_green.csv]
2026-10-16 Phase 4 - Reservoir with feedback + experiment log
    [b16_fb0_s1.csv, b16_fb32_s1.csv, b16f0_s2_dark.csv, b16f16_s1.csv, b16f16_s1_repeat.csv, b16f32_s1_bri.csv, b16f32_s1_rep.csv, b16f32_s2_dark.csv]
2026-10-16 additional files
    [phase3.csv]
